crexodon/Plant_Thing/calathea_copper.png

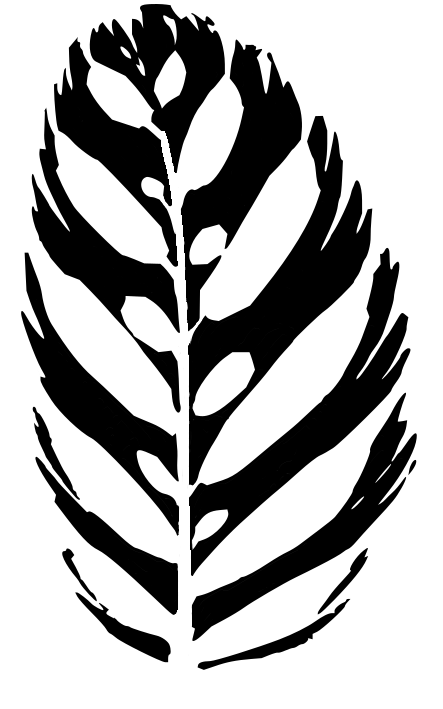
calathea_copper.png
