crexodon/Plant_Thing/PCB/Devboard/calathea/calathea.png

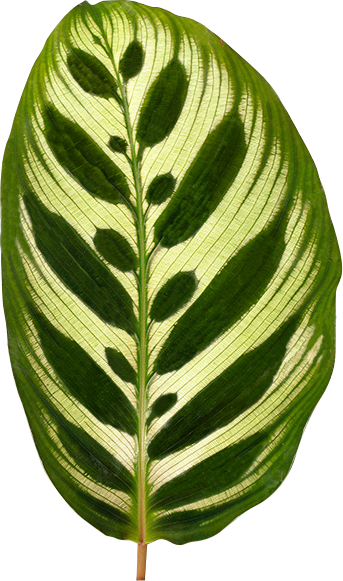
PCB/Devboard/calathea/calathea.png
