crexodon/Plant_Thing/PCB/Devboard/calathea/calathea_copper.png

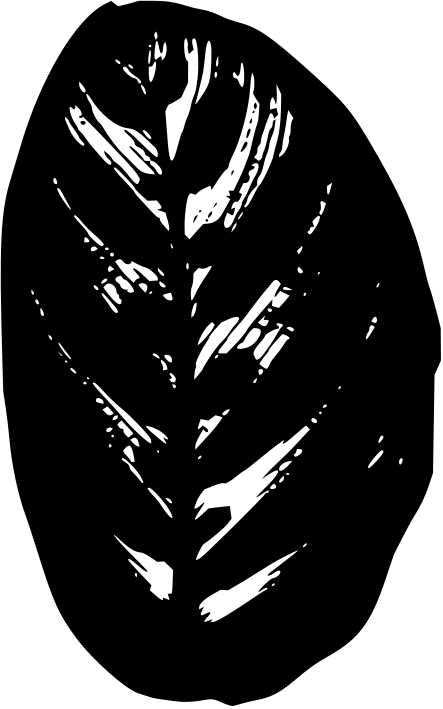
PCB/Devboard/calathea/calathea_copper.png
