crexodon/Plant_Thing/PCB/Devboard/calathea/calathea_edge.png

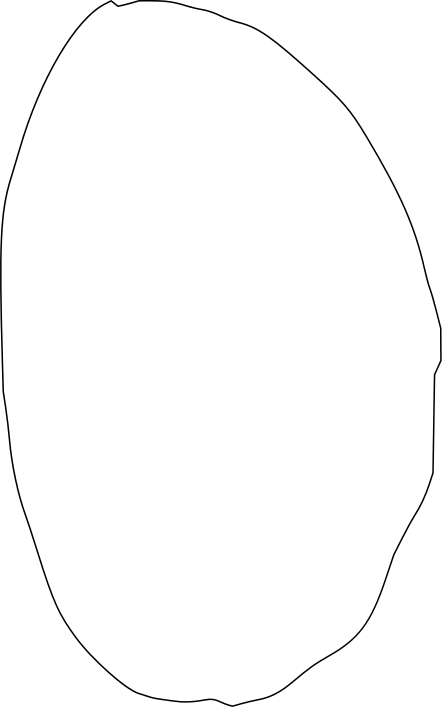
PCB/Devboard/calathea/calathea_edge.png
