crexodon/Plant_Thing/PCB/Devboard/calathea/calathea_fr4.png

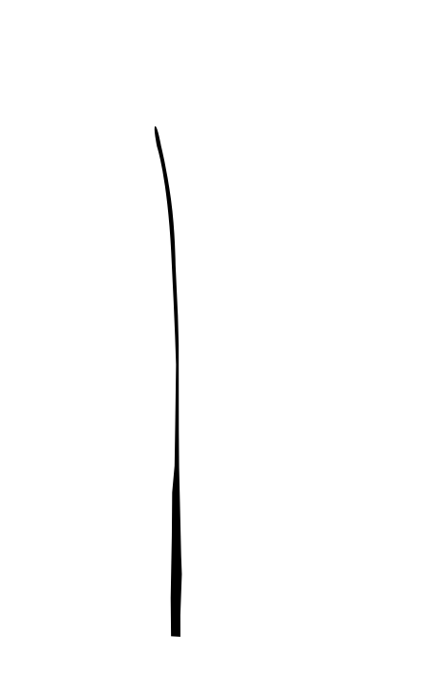
PCB/Devboard/calathea/calathea_fr4.png
