crexodon/Plant_Thing/PCB/Devboard/calathea/calathea_fr4_back.png

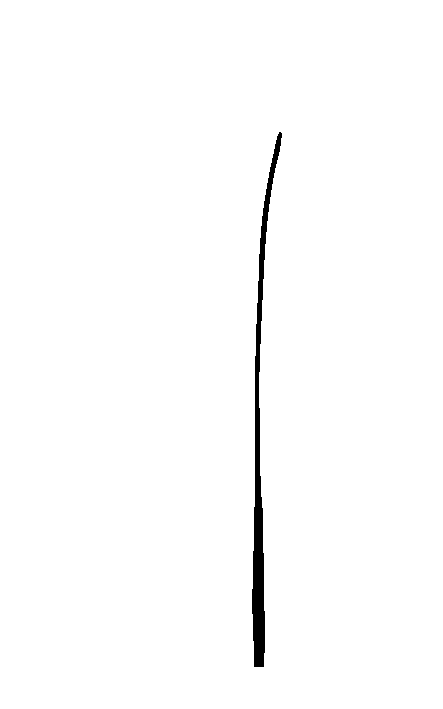
PCB/Devboard/calathea/calathea_fr4_back.png
