crexodon/Plant_Thing/PCB/Devboard/calathea/calathea_mask.png

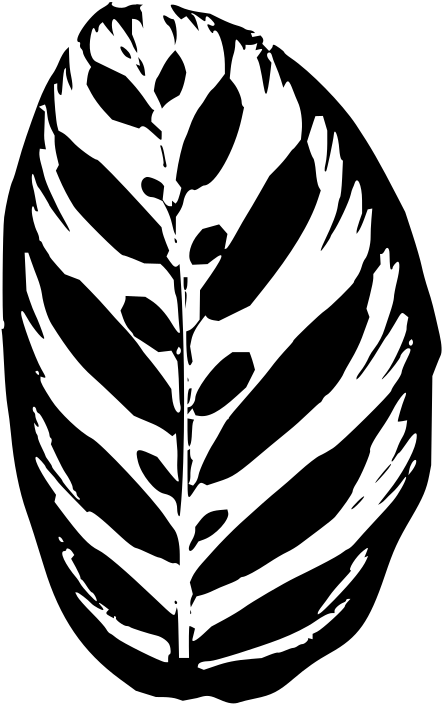
PCB/Devboard/calathea/calathea_mask.png
