crexodon/Plant_Thing/PCB/Devboard/calathea/calathea_silk.png

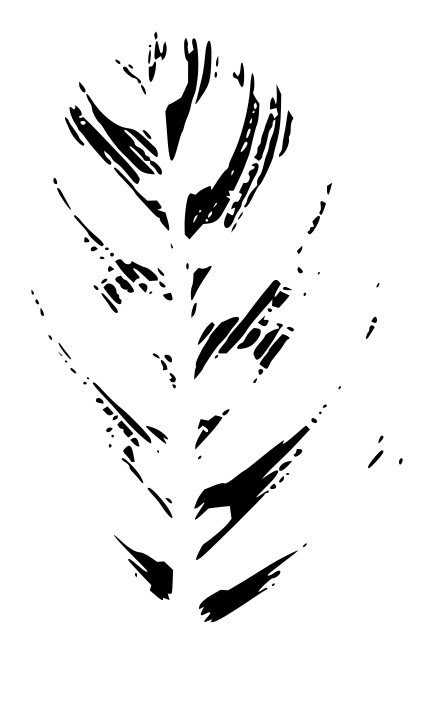
PCB/Devboard/calathea/calathea_silk.png
