crexodon/Plant_Thing/PCB/Devboard/docs/schematic.pdf

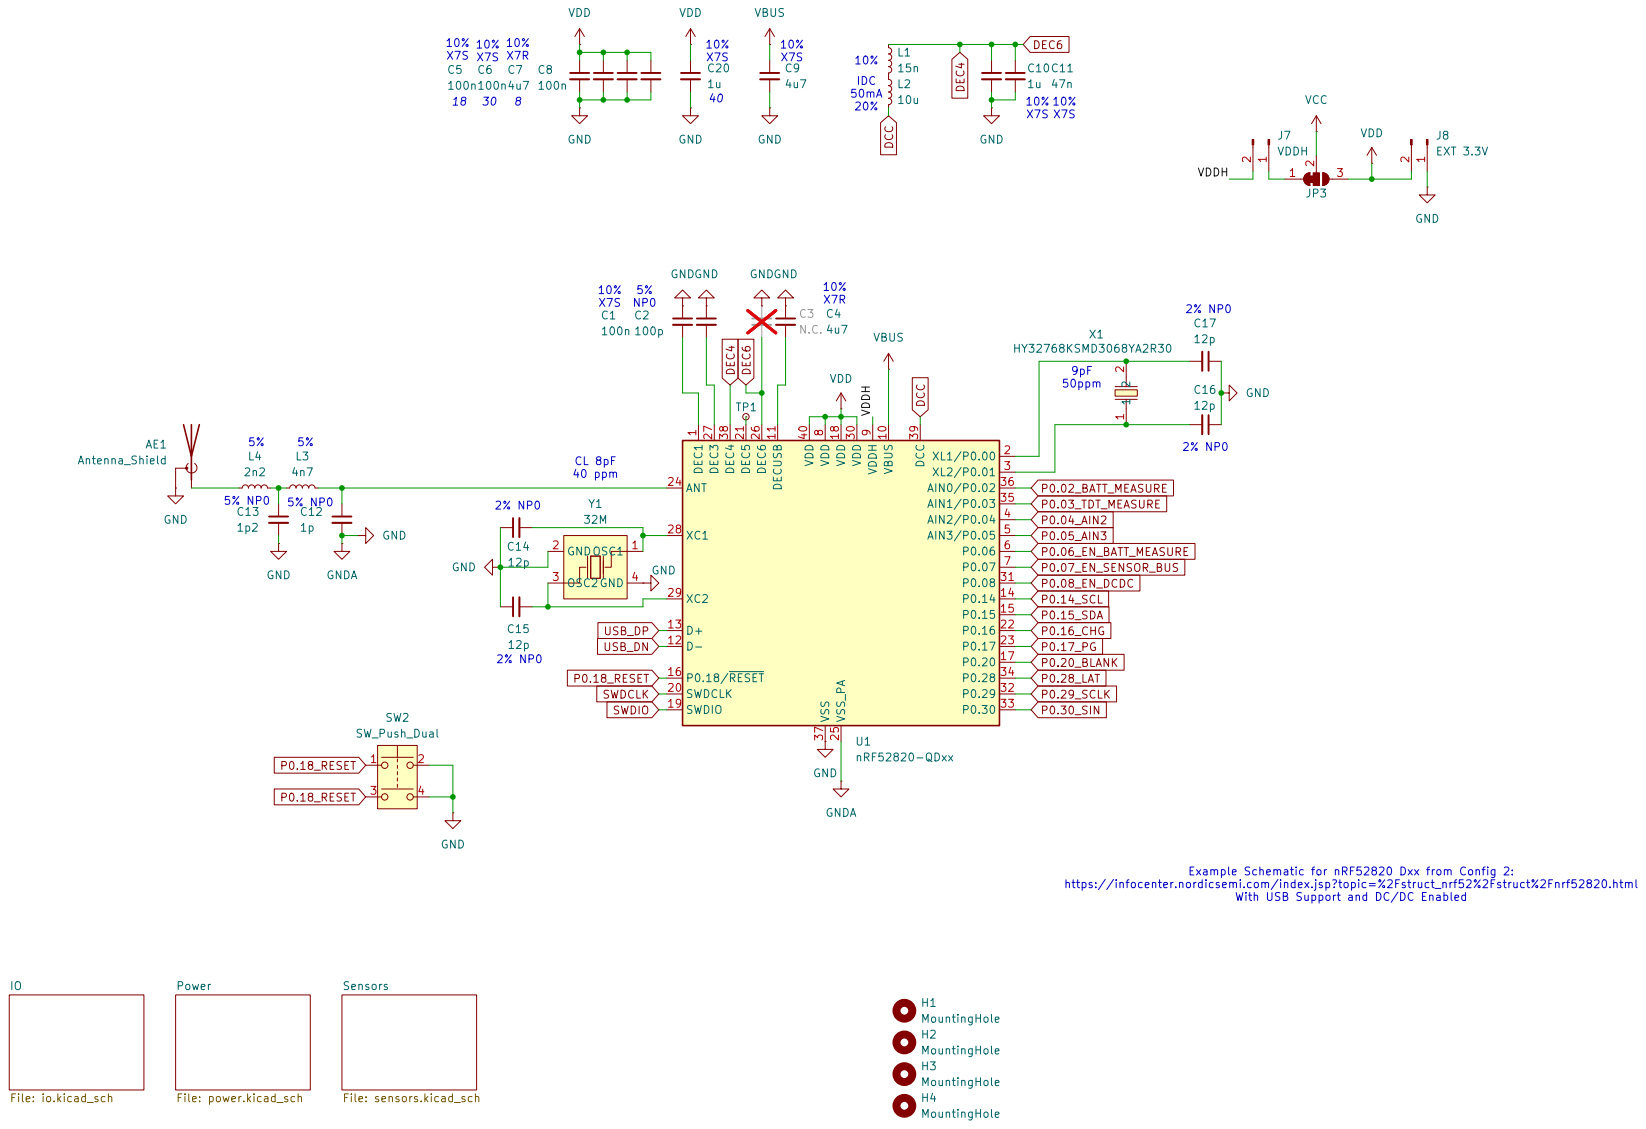
[picture p11: page 1]

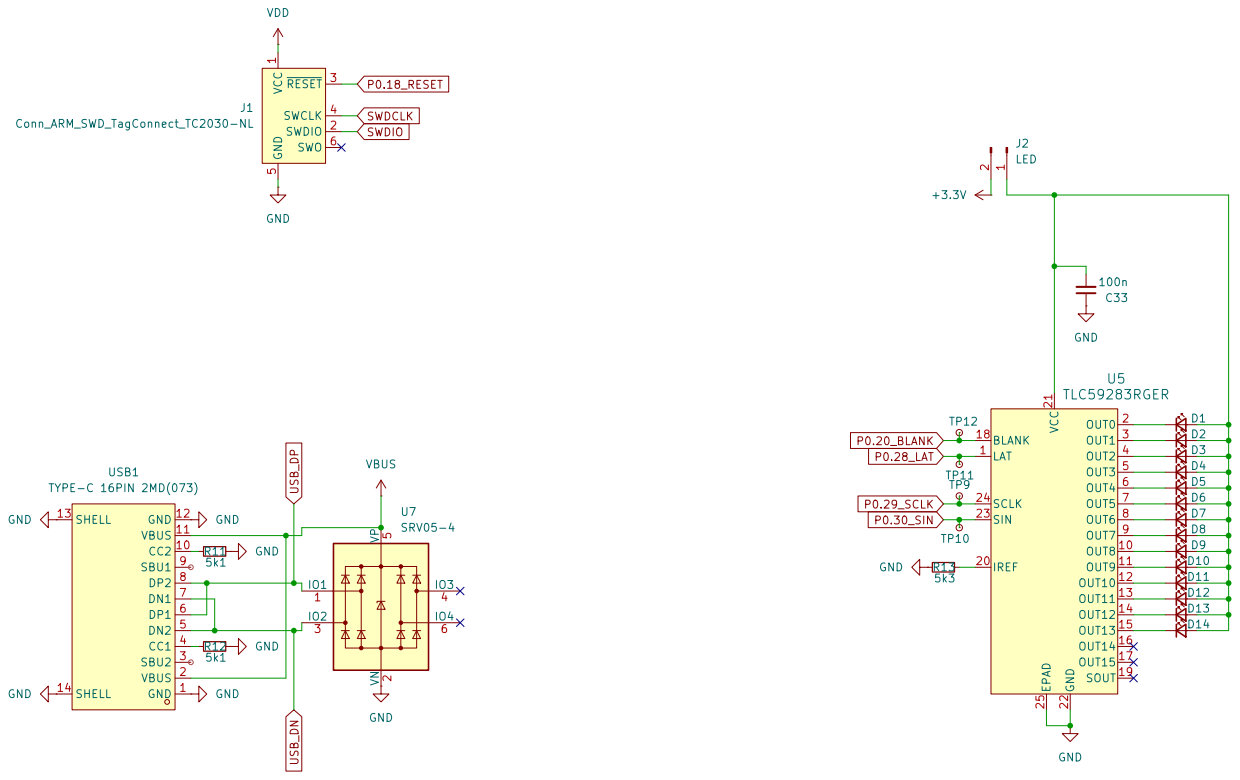
[picture p12: page 2]

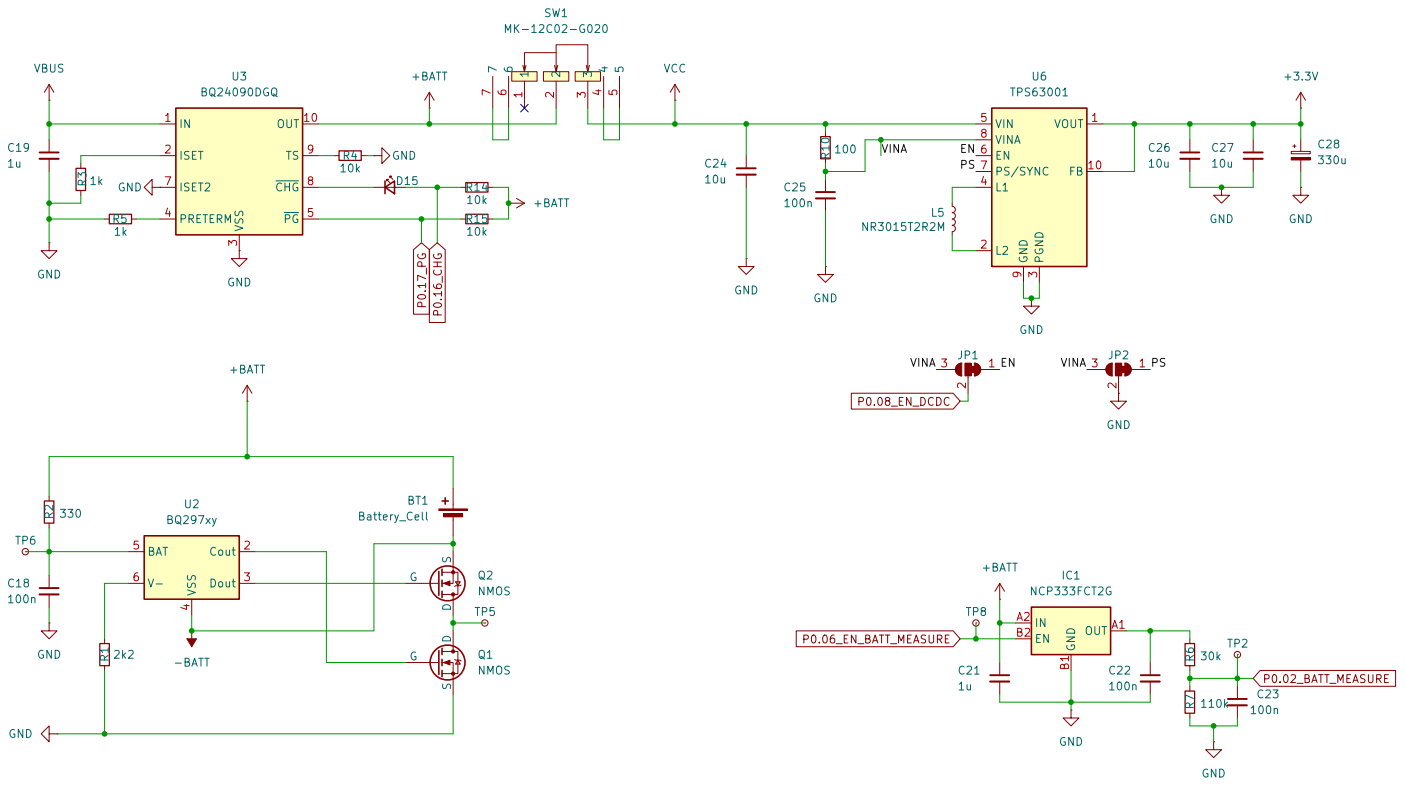
[picture p13: page 3]

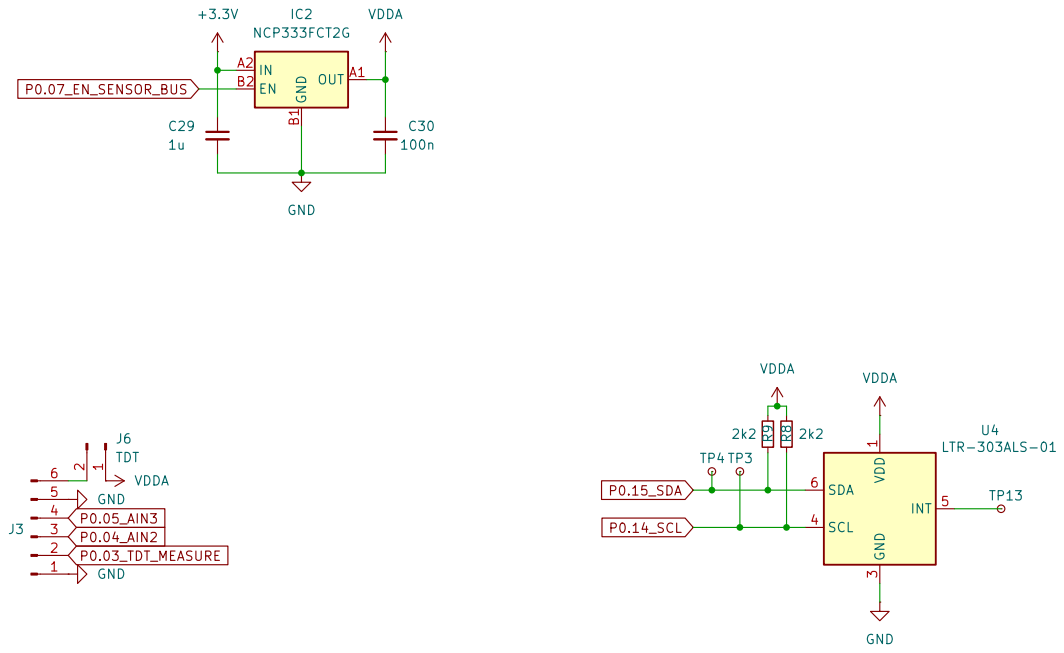
[picture p14: page 4]
