crexodon/Plant_Thing/Plant_Thingv2.kicad_pcb

## KiCad design Plant_Thingv2.kicad_pcb (2024-05-02)

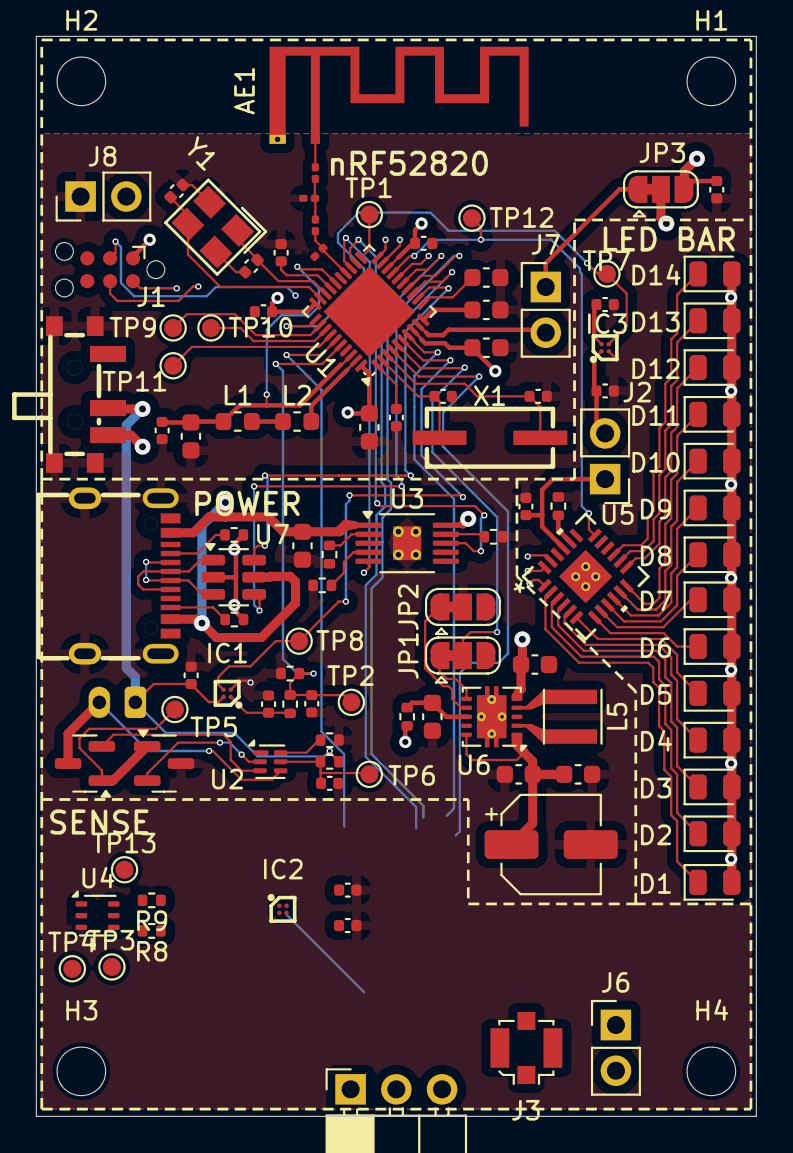
[picture p15: board Plant_Thingv2.kicad_pcb from above]

Board: 4 copper layers, 40.0 x 60.0 mm, 109 parts (1 on the bottom side), 78 nets.

Parts:
AE1: Antenna; Texas_SWRA117D_2.4GHz_Right
BT1: Battery_Cell; JST_PH_S2B-PH-K_1x02_P2.00mm_Horizontal
C1, C5, C6, C8, C18, C22, C23, C30, C31, C32, C33: 100n; C_0402_1005Metric
C2: 100p; C_0402_1005Metric
C4, C7, C9: 4u7; C_0603_1608Metric
C10, C19, C20: 1u; C_0603_1608Metric
C11: 47n; C_0402_1005Metric
C12: 1p; C_0201_0603Metric
C13: 1p2; C_0201_0603Metric
C14, C15, C16, C17: 12p; C_0402_1005Metric
C21, C29: 1u; C_0402_1005Metric
C24, C26, C27: 10u; C_0603_1608Metric
C25: 100n; C_0603_1608Metric
C28: 10u; CP_Elec_5x4.4
D1, D2, D3, D4, D5, D6, D7, D8, D9, D10, D11, D12, D13, D14: LED_Small; LED_0805_2012Metric
H1, H2, H3, H4: MountingHole; MountingHole_2.7mm_M2.5_DIN965
IC1, IC2, IC3: NCP333FCT2G; BGA4C40P2X2_76X76X63
J1: Conn_ARM_SWD_TagConnect_TC2030-NL; Tag-Connect_TC2030-IDC-NL_2x03_P1.27mm_Vertical
J2: LED; PinHeader_1x02_P2.54mm_Vertical
J3: Conn_Coaxial_Small; U.FL_Molex_MCRF_73412-0110_Vertical
J4: Conn_01x03_Socket; PinSocket_1x03_P2.54mm_Horizontal
J6: TDT; PinHeader_1x02_P2.54mm_Vertical
J7: VDDH; PinHeader_1x02_P2.54mm_Vertical
J8: EXT 3.3V; PinHeader_1x02_P2.54mm_Vertical
JP1, JP2, JP3: SolderJumper_3_Bridged12; SolderJumper-3_P1.3mm_Bridged12_RoundedPad1.0x1.5mm
L1: 15n; L_0603_1608Metric
L2: 10u; L_0603_1608Metric
L3: 4n7; L_0201_0603Metric
L4: 2n2; L_0201_0603Metric
L5: NR3015T2R2M; L_Taiyo-Yuden_NR-30xx
Q1, Q2: NMOS; SOT-23
R1, R8, R9: 2k2; R_0402_1005Metric
R2: 330; R_0402_1005Metric
R3, R5: 1k; R_0402_1005Metric
R4: 10k; R_0402_1005Metric
R6: 300; R_0402_1005Metric
R7: 1k1; R_0402_1005Metric
R10: 100; R_0402_1005Metric
R11, R12: 5k1; R_0402_1005Metric
R13: 5k3; R_0402_1005Metric
SW1: MK-12C02-G020; SW-SMD_MK-12C02-G020
TP1, TP2, TP3, TP4, TP5, TP6, TP7, TP8, TP9, TP10, TP11, TP12, TP13: TestPoint_Small; TestPoint_Pad_D1.0mm
U1: nRF52820-QDxx; QFN-40-1EP_5x5mm_P0.4mm_EP3.6x3.6mm
U2: BQ297xy; WSON-6_1.5x1.5mm_P0.5mm
U3: BQ24090DGQ; HVSSOP-10-1EP_3x3mm_P0.5mm_EP1.57x1.88mm_ThermalVias
U4: LTR-303ALS-01; Lite-On_LTR-303ALS-01
U5: TLC59283RGER; RGE24_2P1X2P1_TEX
U6: TPS63001; Texas_DRC0010J_ThermalVias
U7: SRV05-4; SOT-23-6
USB1: TYPE-C 16PIN 2MD(073); USB-C-SMD_TYPE-C-6PIN-2MD-073
X1: HY32768KSMD3068YA2R30; CRYSTAL-SMD_L7.0-W3.2-LS7.5
Y1: 32M; CRYSTAL-SMD_4P-L3.2-W2.5-BL

Connections:
+3.3V: C26.1, C27.1, C28.1, C29.1, C31.1, IC2.A2 (IN), IC3.A2 (IN), U6.1 (VOUT), U6.10 (FB)
+BATT: BT1.1 (+), C21.1, IC1.A2 (IN), R2.1, SW1.2, U3.10 (OUT)
-BATT: BT1.2 (-), Q2.3 (S), U2.4 (VSS)
/Power/EN: JP1.1 (A), U6.6 (EN)
/Power/PS: JP2.1 (A), U6.7 (PS/SYNC)
/Power/VINA: C25.1, JP1.3 (B), JP2.3 (B), R10.2, U6.8 (VINA)
/VDDH: J7.2, U1.9 (VDDH)
DCC: L2.2, U1.39 (DCC)
DEC4: C10.1, C11.1, L1.1, U1.26 (DEC6), U1.38 (DEC4)
GND: C1.1, C2.1, C4.1, C5.2, C6.2, C7.2, C8.2, C9.2, C10.2, C11.2, C12.2, C13.2, C14.1, C15.1, C16.1, C17.1, C18.2, C19.2, C20.2, C21.2, C22.2, C23.2, C24.2, C25.2, C26.2, C27.2, C28.2, C29.2, C30.2, C31.2, C32.2, C33.1, IC1.B1 (GND), IC2.B1 (GND), IC3.B1 (GND), J1.5 (GND), J8.1, JP2.2 (C), Q1.3 (S), R1.2, R3.2, R4.2, R5.1, R7.2, R11.2, R12.2, R13.1, SW1.4, SW1.5, SW1.6, SW1.7, U1.25 (VSS_PA), U1.37 (VSS), U1.41 (VSS), U3.3 (VSS), U3.7 (ISET2), U3.11 (VSS), U4.3 (GND), U5.22 (GND), U5.25 (EPAD), U6.3 (PGND), U6.9 (GND), U6.11 (PGND), U7.2 (VN), USB1.1 (GND), USB1.12 (GND), USB1.13 (SHELL), USB1.14 (SHELL), Y1.2 (GND), Y1.4 (GND)
unnamed: AE1.1 (A), L4.1
unnamed: C13.1, L3.1, L4.2
unnamed: C33.2, D1.2 (A), D2.2 (A), D3.2 (A), D4.2 (A), D5.2 (A), D6.2 (A), D7.2 (A), D8.2 (A), D9.2 (A), D10.2 (A), D11.2 (A), D12.2 (A), D13.2 (A), D14.2 (A), J2.1, U5.21 (VCC)
unnamed: D1.1 (K), U5.2 (OUT0)
unnamed: D2.1 (K), U5.3 (OUT1)
unnamed: D3.1 (K), U5.4 (OUT2)
unnamed: D4.1 (K), U5.5 (OUT3)
unnamed: D5.1 (K), U5.6 (OUT4)
unnamed: D6.1 (K), U5.7 (OUT5)
unnamed: D7.1 (K), U5.8 (OUT6)
unnamed: D8.1 (K), U5.9 (OUT7)
unnamed: D9.1 (K), U5.10 (OUT8)
unnamed: D10.1 (K), U5.11 (OUT9)
unnamed: D11.1 (K), U5.12 (OUT10)
unnamed: D12.1 (K), U5.13 (OUT11)
unnamed: D13.1 (K), U5.14 (OUT12)
unnamed: D14.1 (K), U5.15 (OUT13)
unnamed: C22.1, IC1.A1 (OUT), R6.1
unnamed: C32.1, IC3.A1 (OUT), J2.2
unnamed: J7.1, JP3.1 (A)
unnamed: L1.2, L2.1
unnamed: Q1.1 (D), Q2.1 (D), TP5.1
unnamed: Q1.2 (G), U2.2 (Cout)
unnamed: Q2.2 (G), U2.3 (Dout)
unnamed: C12.1, L3.2, U1.24 (ANT)
unnamed: C1.2, U1.1 (DEC1)
unnamed: C2.2, U1.27 (DEC3)
unnamed: TP1.1, U1.21 (DEC5)
unnamed: C4.2, U1.11 (DECUSB)
unnamed: C14.2, U1.28 (XC1), Y1.1 (OSC1)
unnamed: C15.2, U1.29 (XC2), Y1.3 (OSC2)
unnamed: C17.2, U1.2 (XL1/P0.00), X1.2
unnamed: C16.2, U1.3 (XL2/P0.01), X1.1
unnamed: C18.1, R2.2, TP6.1, U2.5 (BAT)
unnamed: R1.1, U2.6 (V-)
unnamed: R3.1, U3.2 (ISET)
unnamed: R5.2, U3.4 (PRETERM)
unnamed: R4.1, U3.9 (TS)
unnamed: TP13.1, U4.5 (INT)
unnamed: R13.2, U5.20 (IREF)
unnamed: L5.1, U6.4 (L1)
unnamed: L5.2, U6.2 (L2)
unnamed: U7.1 (IO1), USB1.6 (DP1), USB1.8 (DP2)
unnamed: U7.3 (IO2), USB1.5 (DN2), USB1.7 (DN1)
unnamed: R12.1, USB1.4 (CC1)
unnamed: R11.1, USB1.10 (CC2)
P0.02_BATT_MEASURE: C23.1, R6.2, R7.1, TP2.1, U1.36 (AIN0/P0.02)
P0.05_EN_DCDC: JP1.2 (C), U1.5 (AIN3/P0.05)
P0.06_EN_BATT_MEASURE: IC1.B2 (EN), TP8.1, U1.6 (P0.06)
P0.07_EN_SENSOR_BUS: IC2.B2 (EN), U1.7 (P0.07)
P0.08_EN_LED: IC3.B2 (EN), TP7.1, U1.31 (P0.08)
P0.14_SCL: R8.2, TP3.1, U1.14 (P0.14), U4.4 (SCL)
P0.15_SDA: R9.2, TP4.1, U1.15 (P0.15), U4.6 (SDA)
P0.16_CHG: U1.22 (P0.16), U3.8 (~CHG)
P0.17_PG: U1.23 (P0.17), U3.5 (~PG)
P0.18_RESET: J1.3 (~RESET), U1.16 (P0.18/~RESET)
P0.20_BLANK: TP12.1, U1.17 (P0.20), U5.18 (BLANK)
P0.28_LAT: TP11.1, U1.34 (P0.28), U5.1 (LAT)
P0.29_SCLK: TP9.1, U1.32 (P0.29), U5.24 (SCLK)
P0.30_SIN: TP10.1, U1.33 (P0.30), U5.23 (SIN)
SWDCLK: J1.4 (SWCLK), U1.20 (SWDCLK)
SWDIO: J1.2 (SWDIO), U1.19 (SWDIO)
USB_DN: U1.12 (D-), U7.6 (IO4)
USB_DP: U1.13 (D+), U7.4 (IO3)
VBUS: C9.1, C19.1, U1.10 (VBUS), U3.1 (IN), U7.5 (VP), USB1.2 (VBUS), USB1.11 (VBUS)
VCC: C24.1, JP3.2 (C), R10.1, SW1.3, U6.5 (VIN)
VDD: C5.1, C6.1, C7.1, C8.1, C20.1, J1.1 (VCC), J8.2, JP3.3 (B), U1.8 (VDD), U1.18 (VDD), U1.30 (VDD), U1.40 (VDD)
VDDA: C30.1, IC2.A1 (OUT), R8.1, R9.1, U4.1 (VDD)
