crexodon/Plant_Thing/(commit log)

2024-04-13 Initial Commit and creation of pcb project with kicad
    [Plant_Thing.kicad_pcb, Plant_Thing.kicad_sch, io.kicad_sch, power.kicad_sch, sensors.kicad_sch]
2024-04-13 added reference schematic for nrf52820 and placed components for power
    [Plant_Thing.kicad_sch, io.kicad_sch, power.kicad_sch]
2024-04-13 Added more power components
    [Plant_Thing.kicad_sch, power.kicad_sch]
2024-04-15 Added more components and added most needed values for the nrf example schematic
    [Plant_Thing.kicad_sch, io.kicad_sch, power.kicad_sch, sensors.kicad_sch]
2024-04-25 Added the Calathea Leaf as the outline and artwork for the project
    [Plant_Thing.kicad_pcb, Plant_Thing.kicad_sch, io.kicad_sch, power.kicad_sch, sensors.kicad_sch]
2024-04-25 Added LED Driver IC for the led bar inside the calathea leaf
    [Plant_Thing.kicad_pcb, io.kicad_sch]
2024-04-27 added dcdc for external components. Changed board edge to a rect for easier dev board routuing.
    [Plant_Thing.kicad_pcb, Plant_Thing.kicad_sch, io.kicad_sch, power.kicad_sch, sensors.kicad_sch]
2024-04-27 redid the pcb layout for a more bigger devboard approach. Added a few more components and the antenna.
    [Plant_Thing.kicad_pcb, Plant_Thing.kicad_sch, io.kicad_sch, power.kicad_sch, sensors.kicad_sch]
2024-04-30 Added more Components
    [Plant_Thing.kicad_sch, io.kicad_sch, power.kicad_sch, sensors.kicad_sch]
2024-05-02 Continued on Devboard
    [Plant_Thing.kicad_pcb, Plant_Thing.kicad_sch, Plant_Thingv2.kicad_pcb, io.kicad_sch, power.kicad_sch, sensors.kicad_sch]
2024-05-27 Finished Devboard
    [BOM-Plant_Thing.csv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]
2024-05-27 moved project to devboard folder, added README with schematic, images and description of devboard
    [BOM-Plant_Thing.csv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]
